shinobi-14/Propulsion_Tb/images/Prop_tb_down.jpg

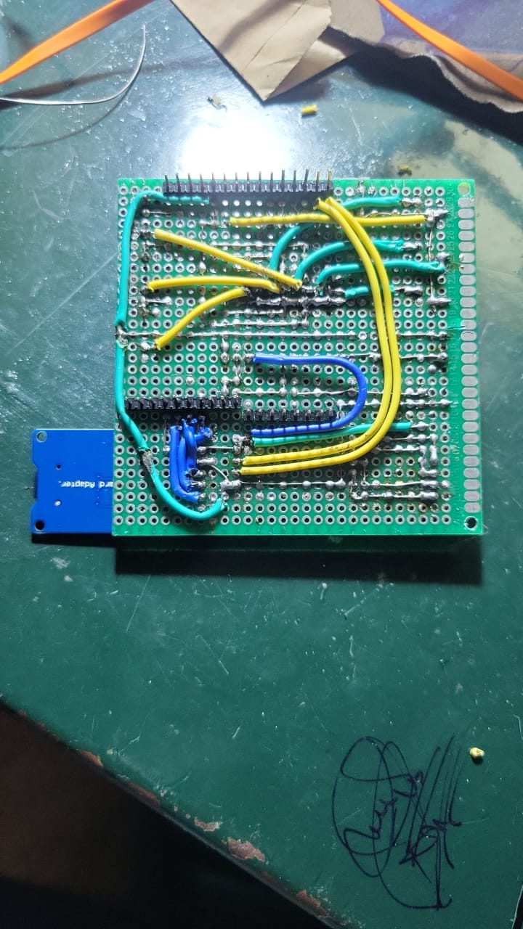
images/Prop_tb_down.jpg
