shinobi-14/Propulsion_Tb/images/Workbench.jpg

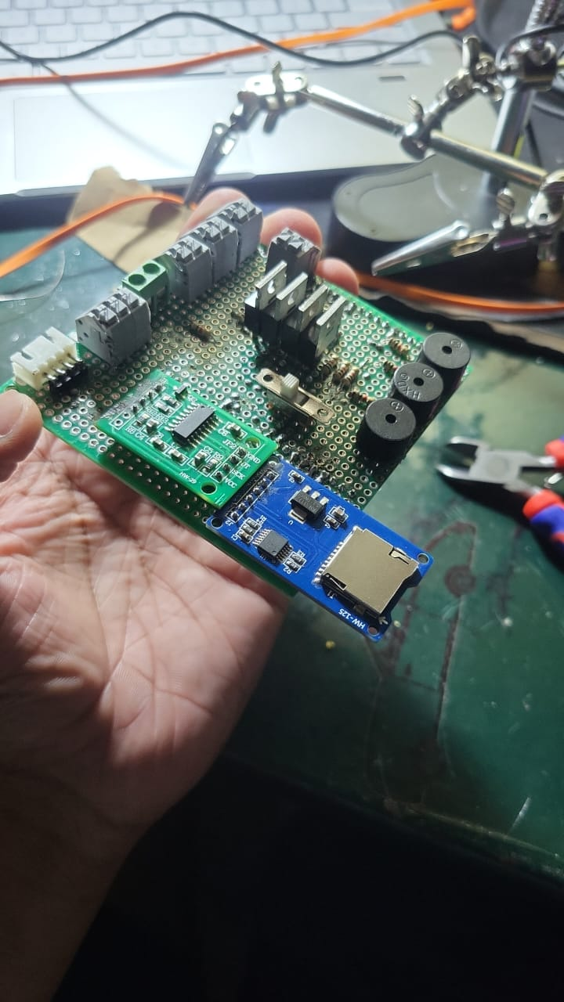
images/Workbench.jpg
