shinobi-14/Propulsion_Tb/README.md

# Propulsion_Testbench
This project is a rocket propulsion testbench built using Arduino. It uses an HX711 load cell amplifier to measure thrust, logs the data to an SD card, and controls ignition through a MOSFET for safety.

The system indicates its current state through a buzzer and three LED strips, which are connected to the perfboard via screw terminals and wrapped around the motor test stand. The buzzer produces different tones, and the LED strips change colors to match each state.

The four states are as follows:
```
0 - Pre-Ignition
1 - Armed
2 - Standby
3 - Abort
```
The schematic for this testbench is created in KiCad (PDF attached for reference), and the circuit is designed using the open-source DIY Layout Creator.

The perfboard design allowed most components to be soldered as standalone modules, keeping the setup straightforward and making debugging easier during testing.

Overall, the system is aimed at providing a simple, reliable, and easy-to-use setup for testing and analyzing rocket motor performance.

<div align="center">
  
  
</div>

<div align="center">

</div>

Author: Prithvi Raj Singh (shinobi-14)
