shinobi-14/Propulsion_Tb/images/E-matches.jpg

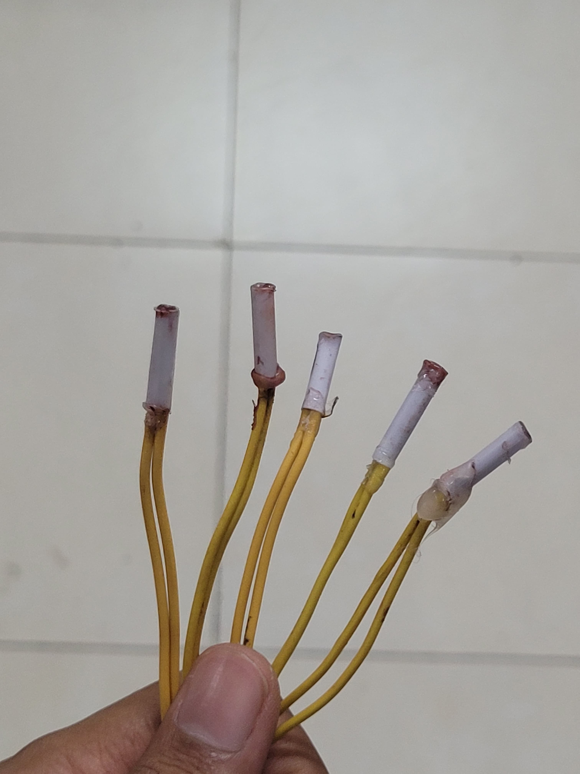
images/E-matches.jpg
