shinobi-14/Propulsion_Tb/images/Prop_tb_top.jpg

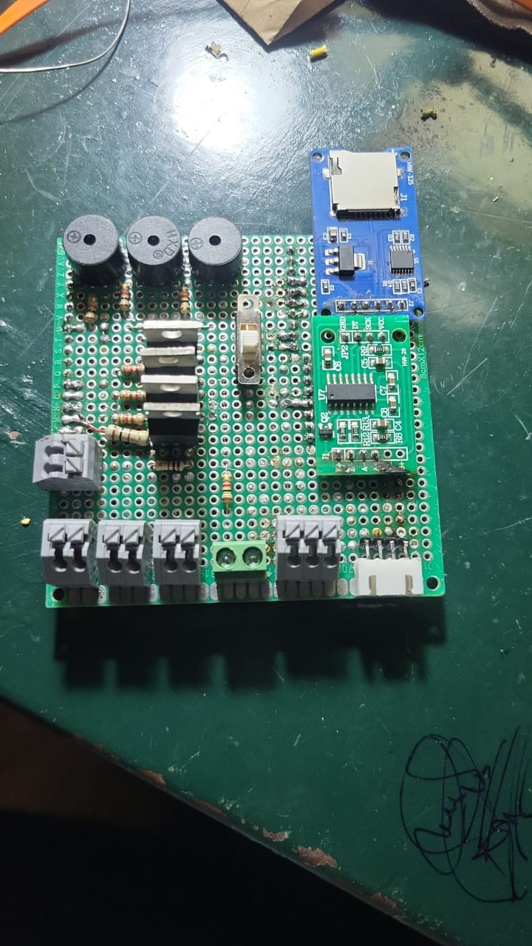
images/Prop_tb_top.jpg
