shinobi-14/Propulsion_Tb/DIYLC_files/PROPULSION_Testbench BOM.xls

Name | Value | Quantity | Notes
100, 100, 100, 100, 1k, 1k, 1k, 1k, 1k, 1k, 1k, 1k |  | 12
Perf Board w/ Pads |  | 1
BZ1, BZ2, BZ3 |  | 3
PH1, PH2, PH3, PH4 |  | 4
Q1, Q2, Q3, Q4 |  | 4
SW1 | SPDT (On/Off/On) | 1
TB1, TB2, TB3, TB4, TB7, TB8 | Two | 6
TB5 | Three | 1
TB6 | Four | 1
