shinobi-14/Propulsion_Tb/Schematics.pdf

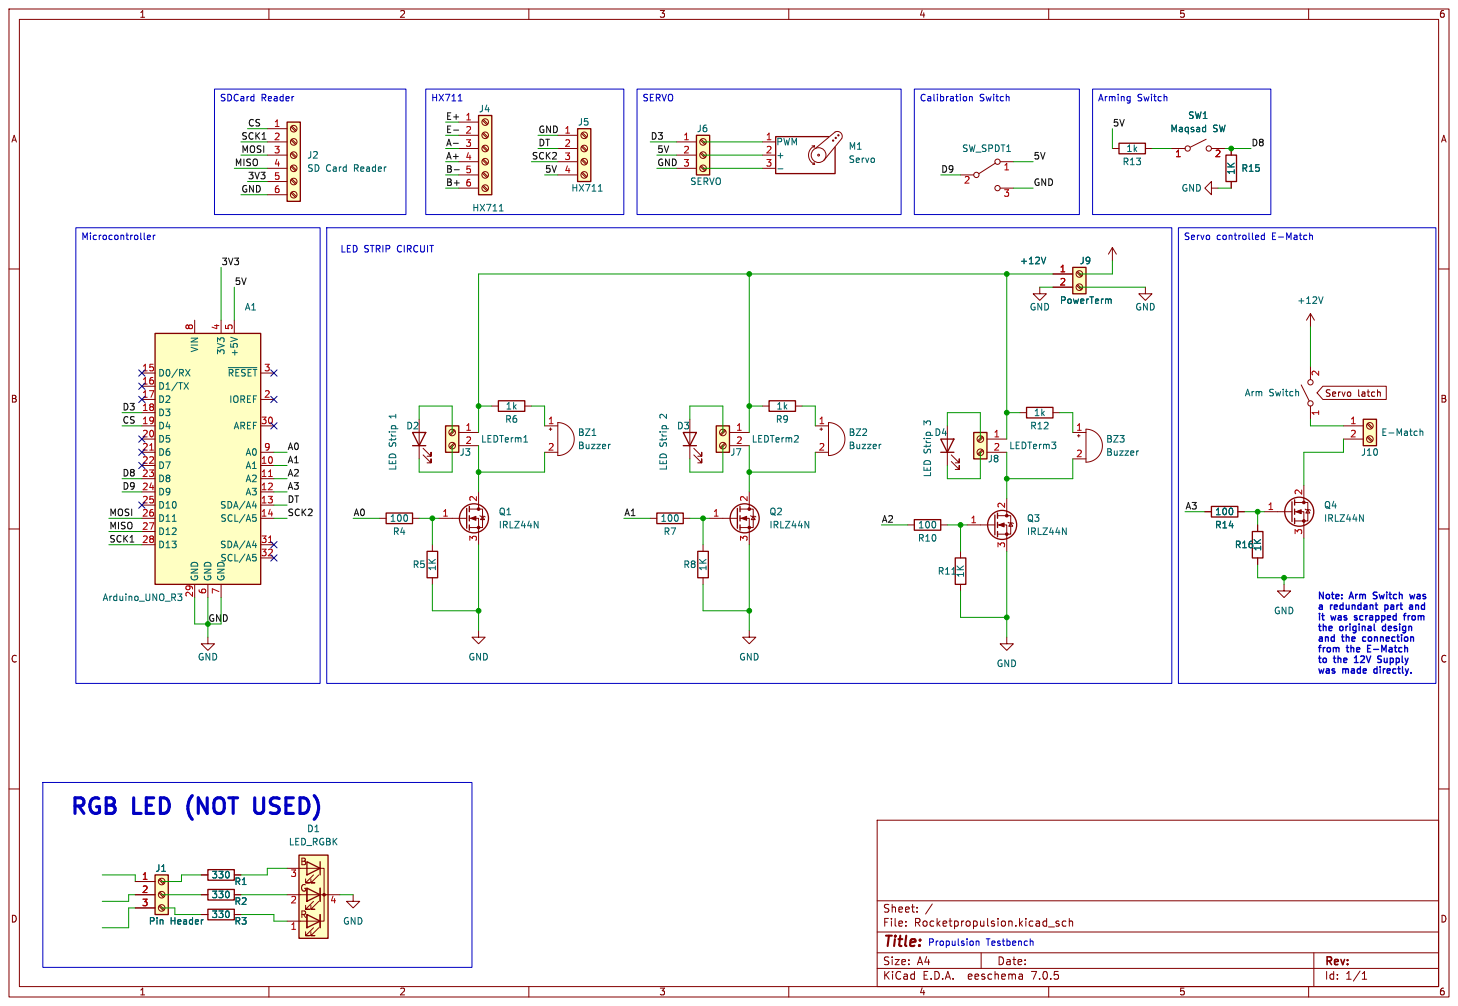
[picture p5: page 1]

a redundant part and
it was scrapped from
the original design
and the connection
from the E-Match
to the 12V Supply was made directly.

RGB LED (NOT USED)
