shinobi-14/Propulsion_Tb/veroboard_layout/PROPULSION_Testbench.pdf

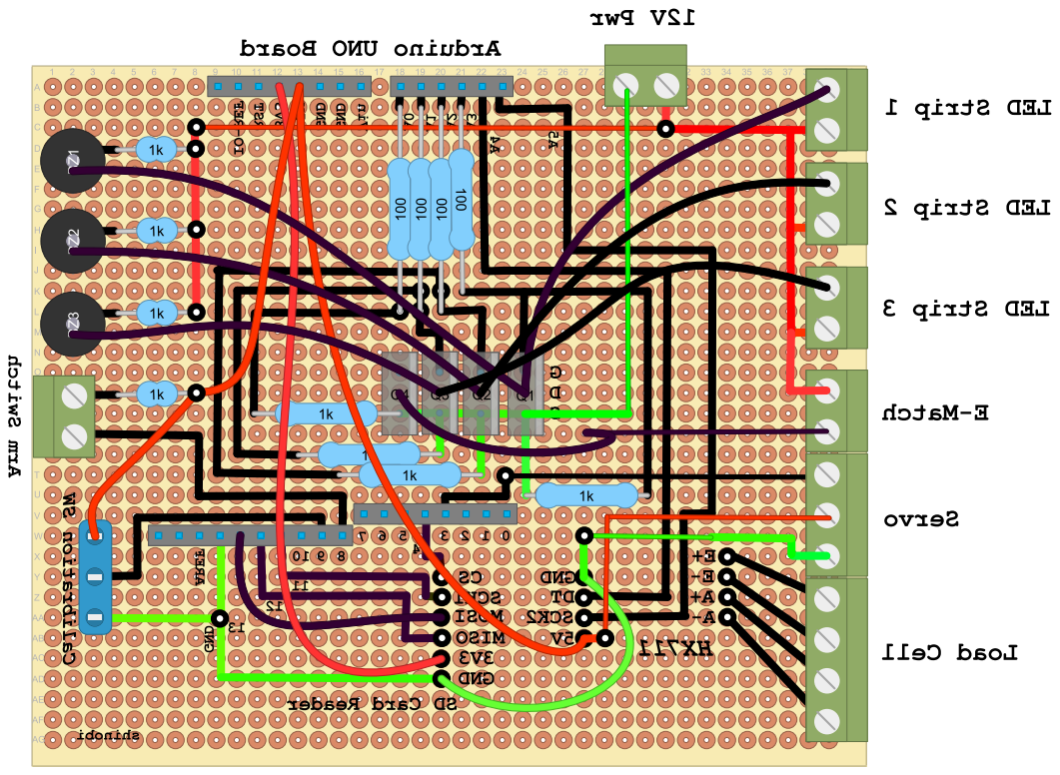
[picture p6: page 1]
