shinobi-14/Propulsion_Tb/veroboard_layout/PROPULSION_Testbench.png

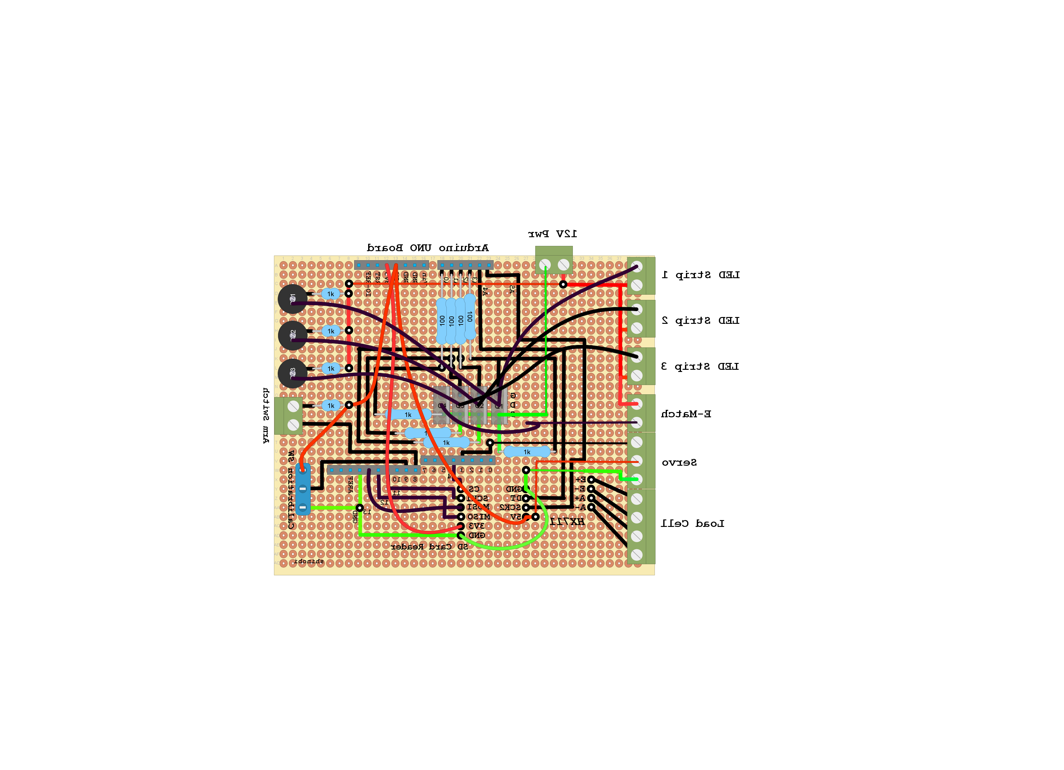
veroboard_layout/PROPULSION_Testbench.png
